RCS101/Nixie-Bargraph-Driver/Affinity Instruction files/instructions photos/Final/completed.png

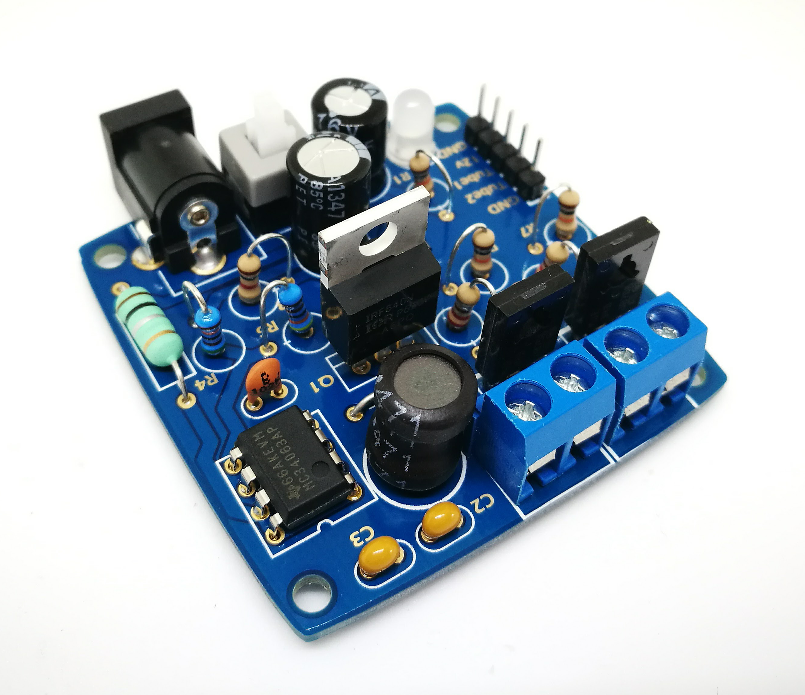
Affinity Instruction files/instructions photos/Final/completed.png
