RCS101/Nixie-Bargraph-Driver/README.md

# Nixie-Bargraph-Driver
Example Sketches
