RCS101/Nixie-Bargraph-Driver/Oak mount design files/Laser etch legend.dxf

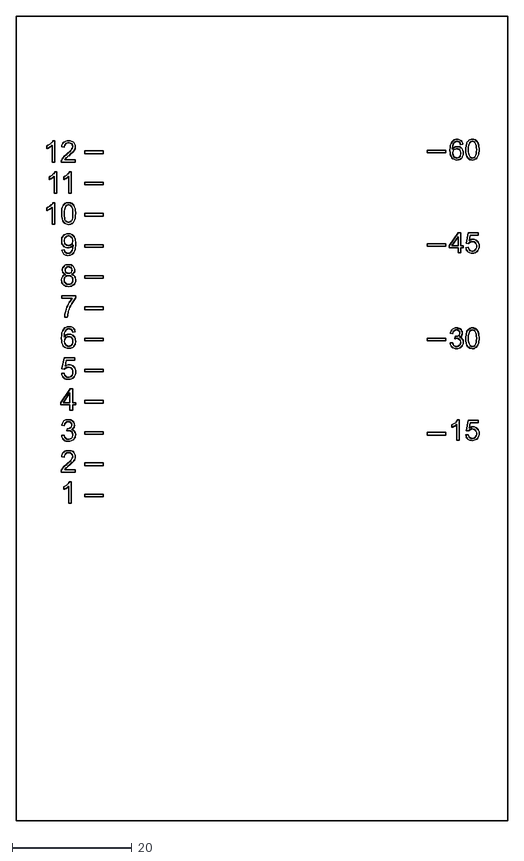
[picture p3: CAD file, 2017-11-06]
Oak mount design files/Laser etch legend.dxf
82.2 x 134.6
