RCS101/Nixie-Bargraph-Driver/Oak mount design files/CNC drill holes.dxf

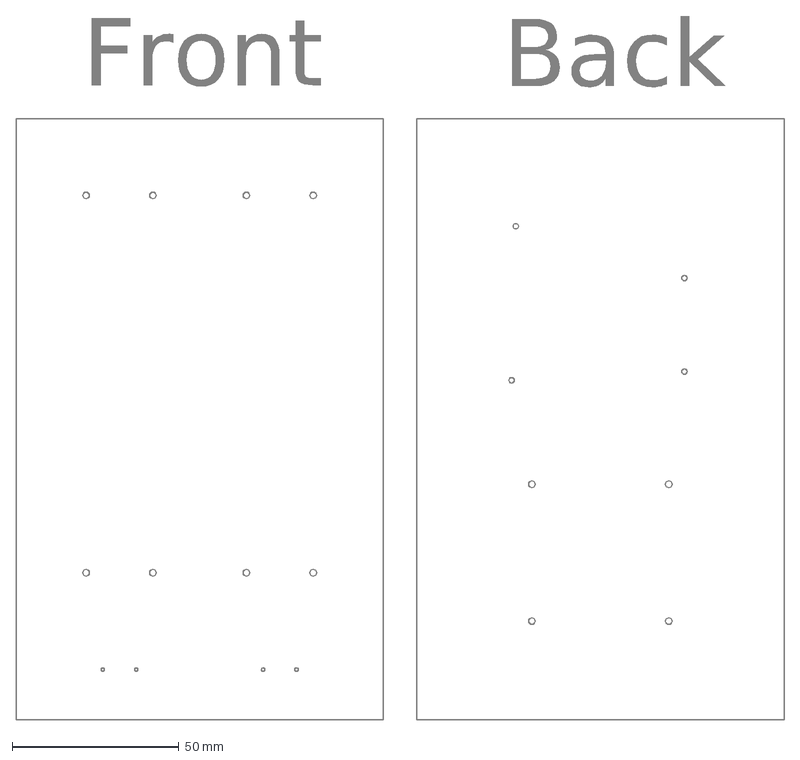
[picture p4: CAD file, 2017-11-06]
Oak mount design files/CNC drill holes.dxf
Back
Front
