RCS101/Nixie-Bargraph-Driver/Affinity Instruction files/instructions photos/Final/contents labelled.png

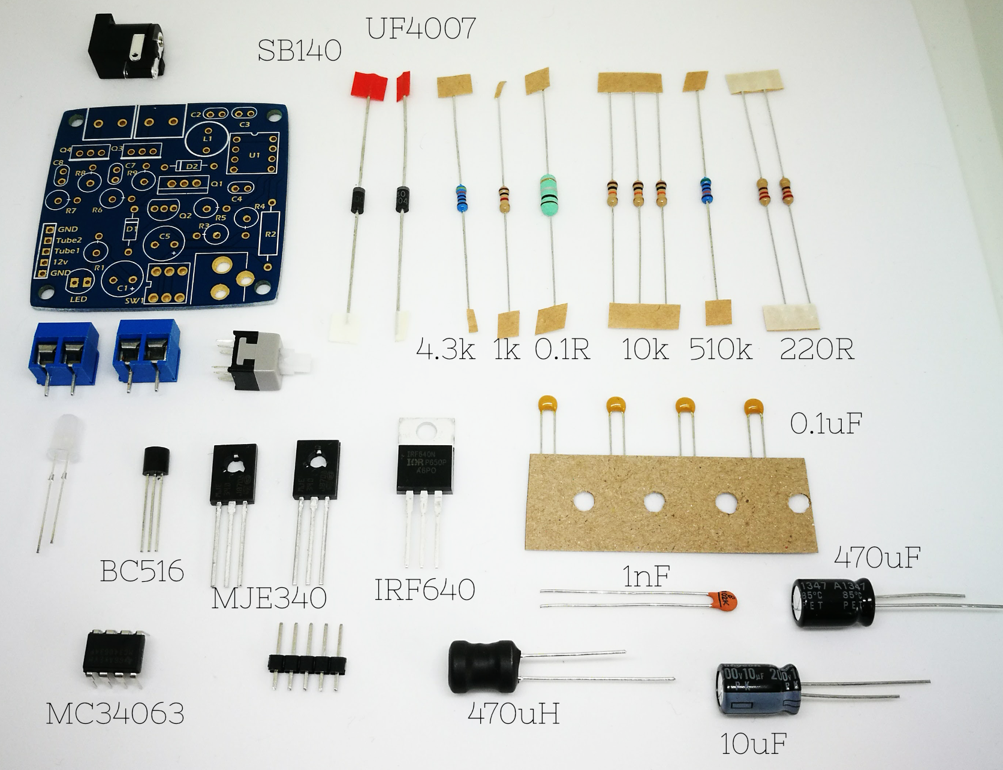
Affinity Instruction files/instructions photos/Final/contents labelled.png
