RCS101/Nixie-Bargraph-Driver/Affinity Instruction files/instructions photos/Final/diode.png

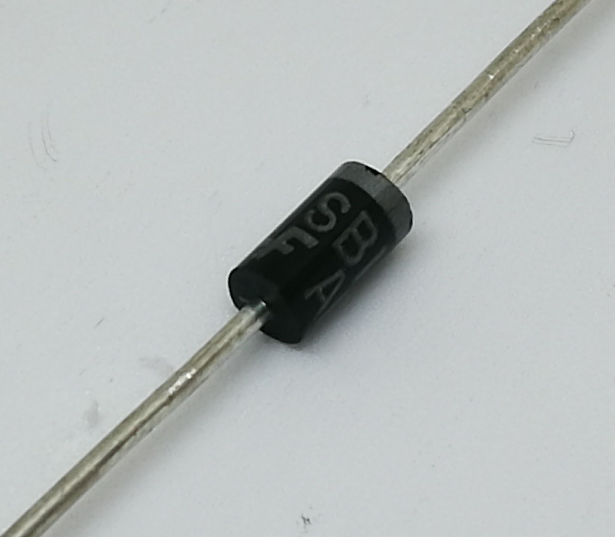
Affinity Instruction files/instructions photos/Final/diode.png
