RCS101/Nixie-Bargraph-Driver/Affinity Instruction files/instructions photos/Final/inductor.png

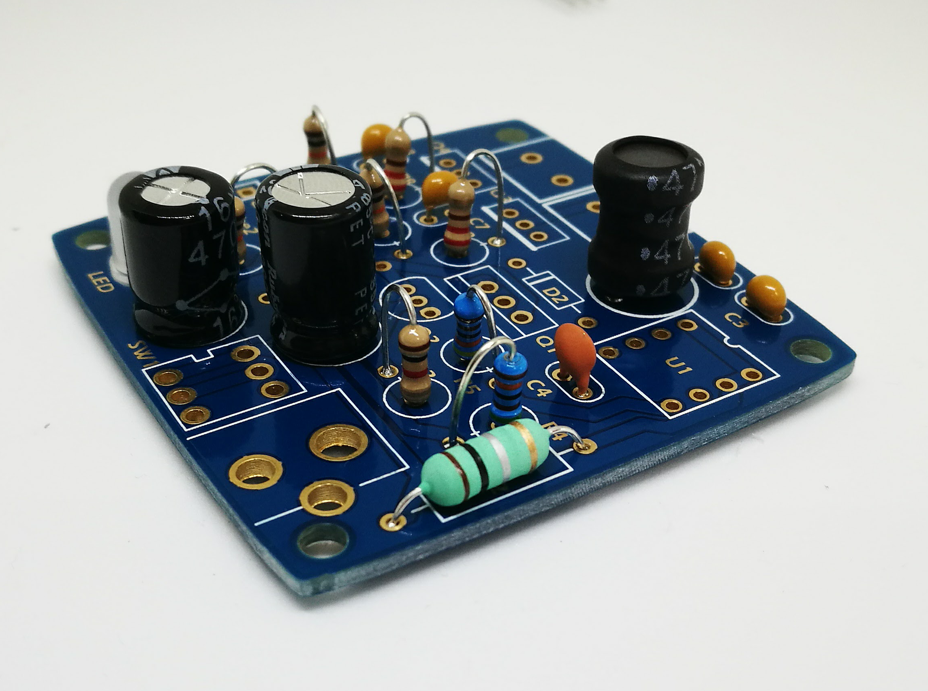
Affinity Instruction files/instructions photos/Final/inductor.png
