RCS101/Nixie-Bargraph-Driver/Affinity Instruction files/instructions photos/Final/resistor.png

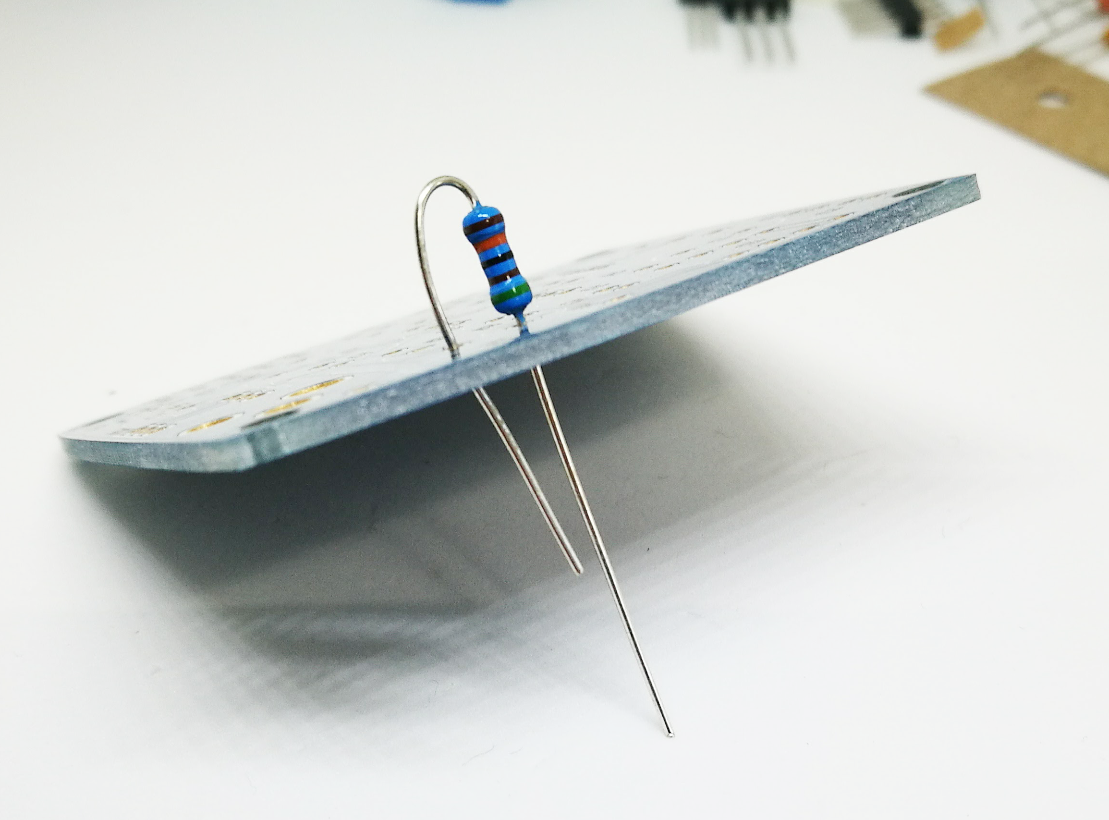
Affinity Instruction files/instructions photos/Final/resistor.png
