RCS101/Nixie-Bargraph-Driver/Affinity Instruction files/instructions photos/IMG_20170730_110608.jpg

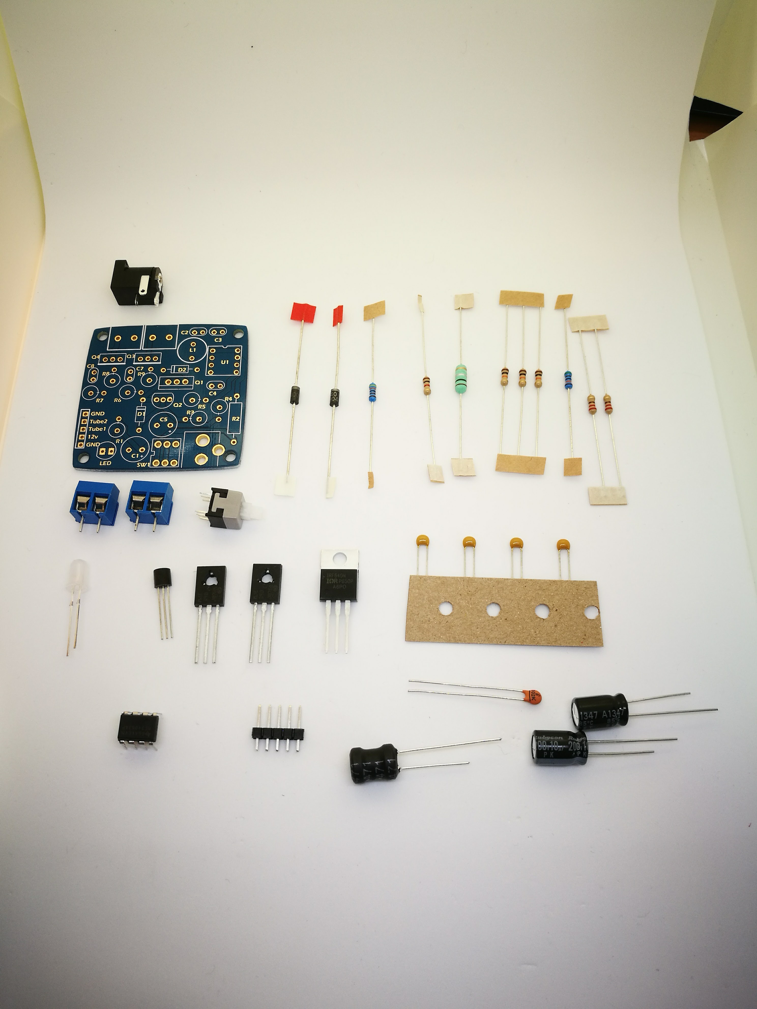
Affinity Instruction files/instructions photos/IMG_20170730_110608.jpg
