RCS101/Nixie-Bargraph-Driver/Affinity Instruction files/instructions photos/IMG_20170730_111332.jpg

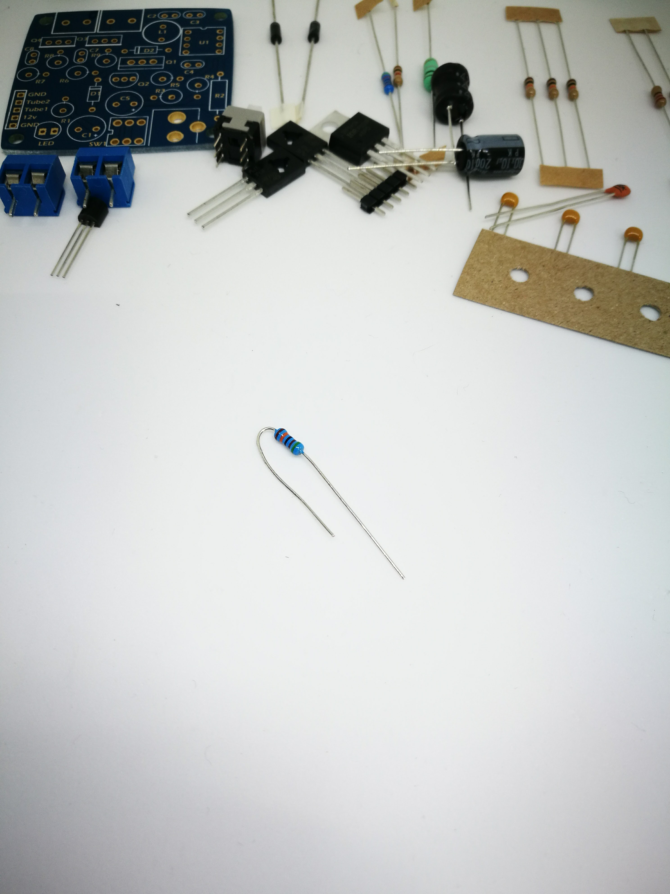
Affinity Instruction files/instructions photos/IMG_20170730_111332.jpg
