RCS101/Nixie-Bargraph-Driver/Schematic.pdf

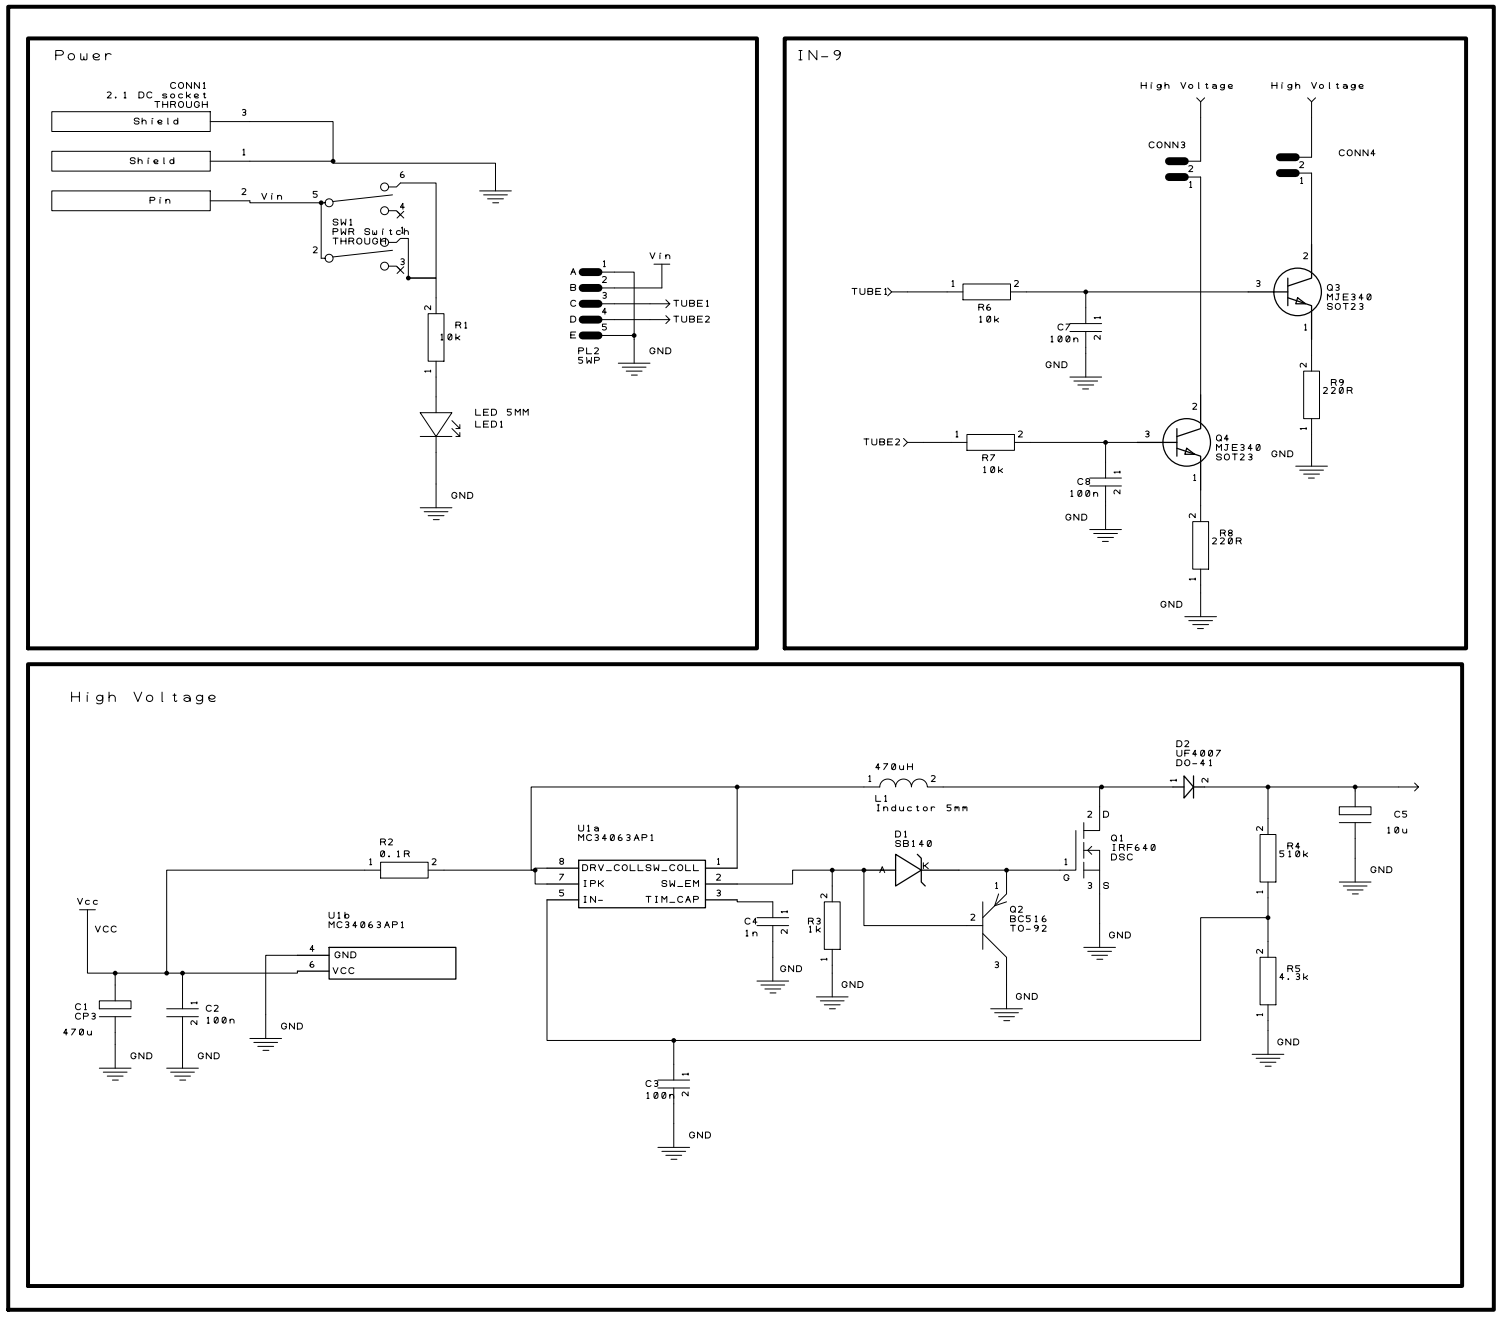
[picture p42: page 1]
