RCS101/Nixie-Bargraph-Driver/(commit log)

2017-10-10 Added schematic
2017-11-06 Added wood mount design files
    [CNC drill holes.dxf, Laser etch legend.dxf]
